mas-ka/ICCC/docs/導通チェッカー_基板製作図.pdf

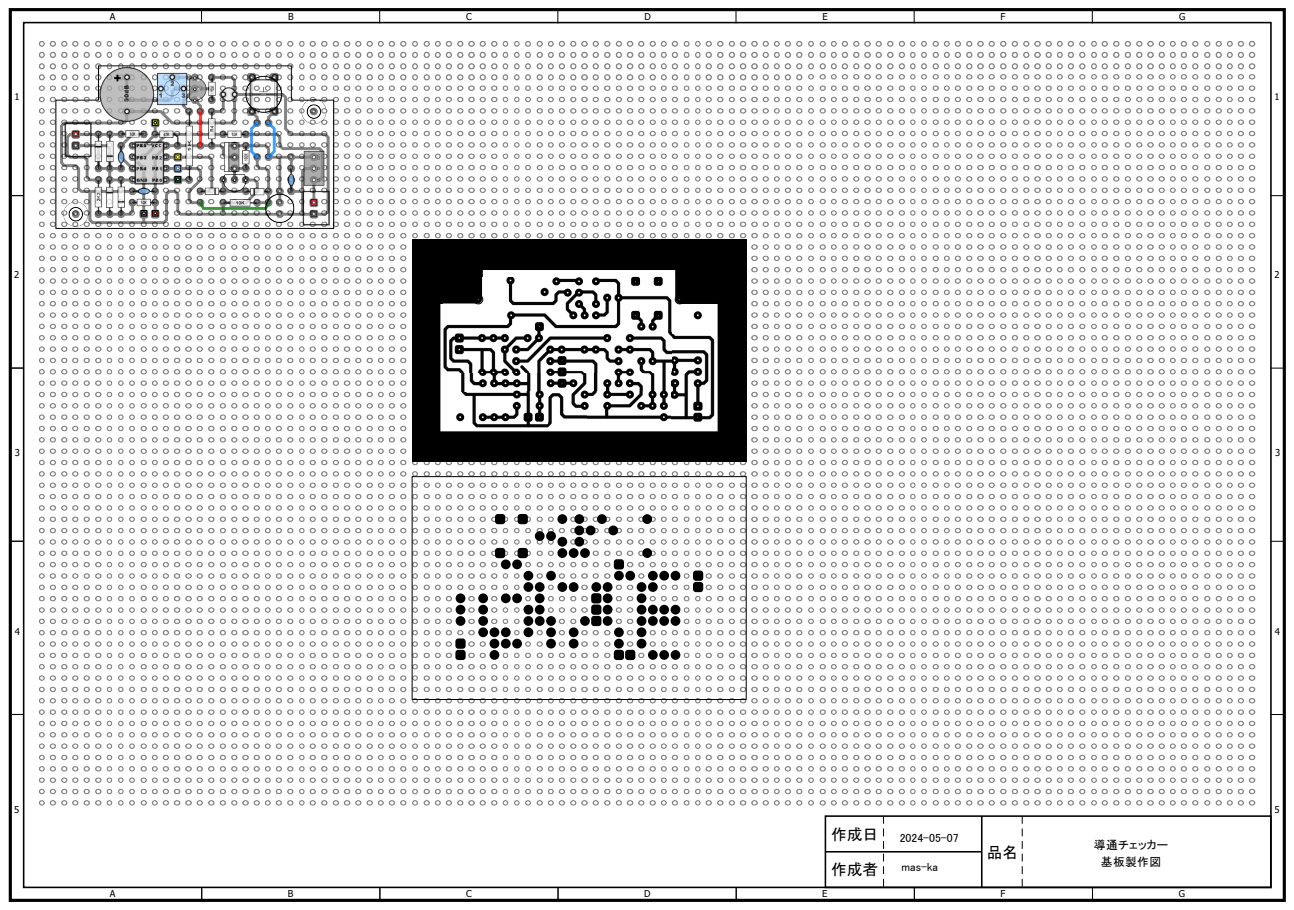
[picture p1: page 1]
作成日; 作成者; mas-ka; 導通チェッカー; 基板製作図
