mas-ka/ICCC/docs/導通チェッカー_転写パターン図.pdf

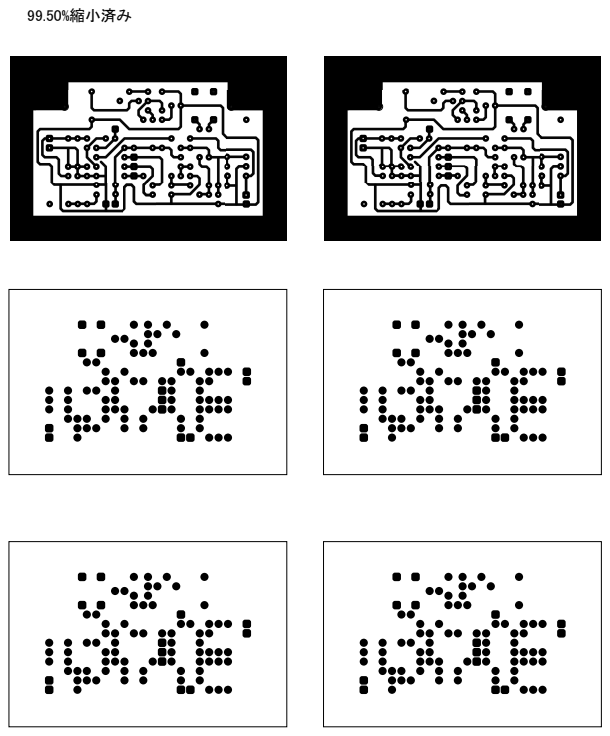
[picture p2: page 1]
99.50%縮小済み
