mas-ka/ICCC/docs/導通チェッカー_電気回路図.pdf

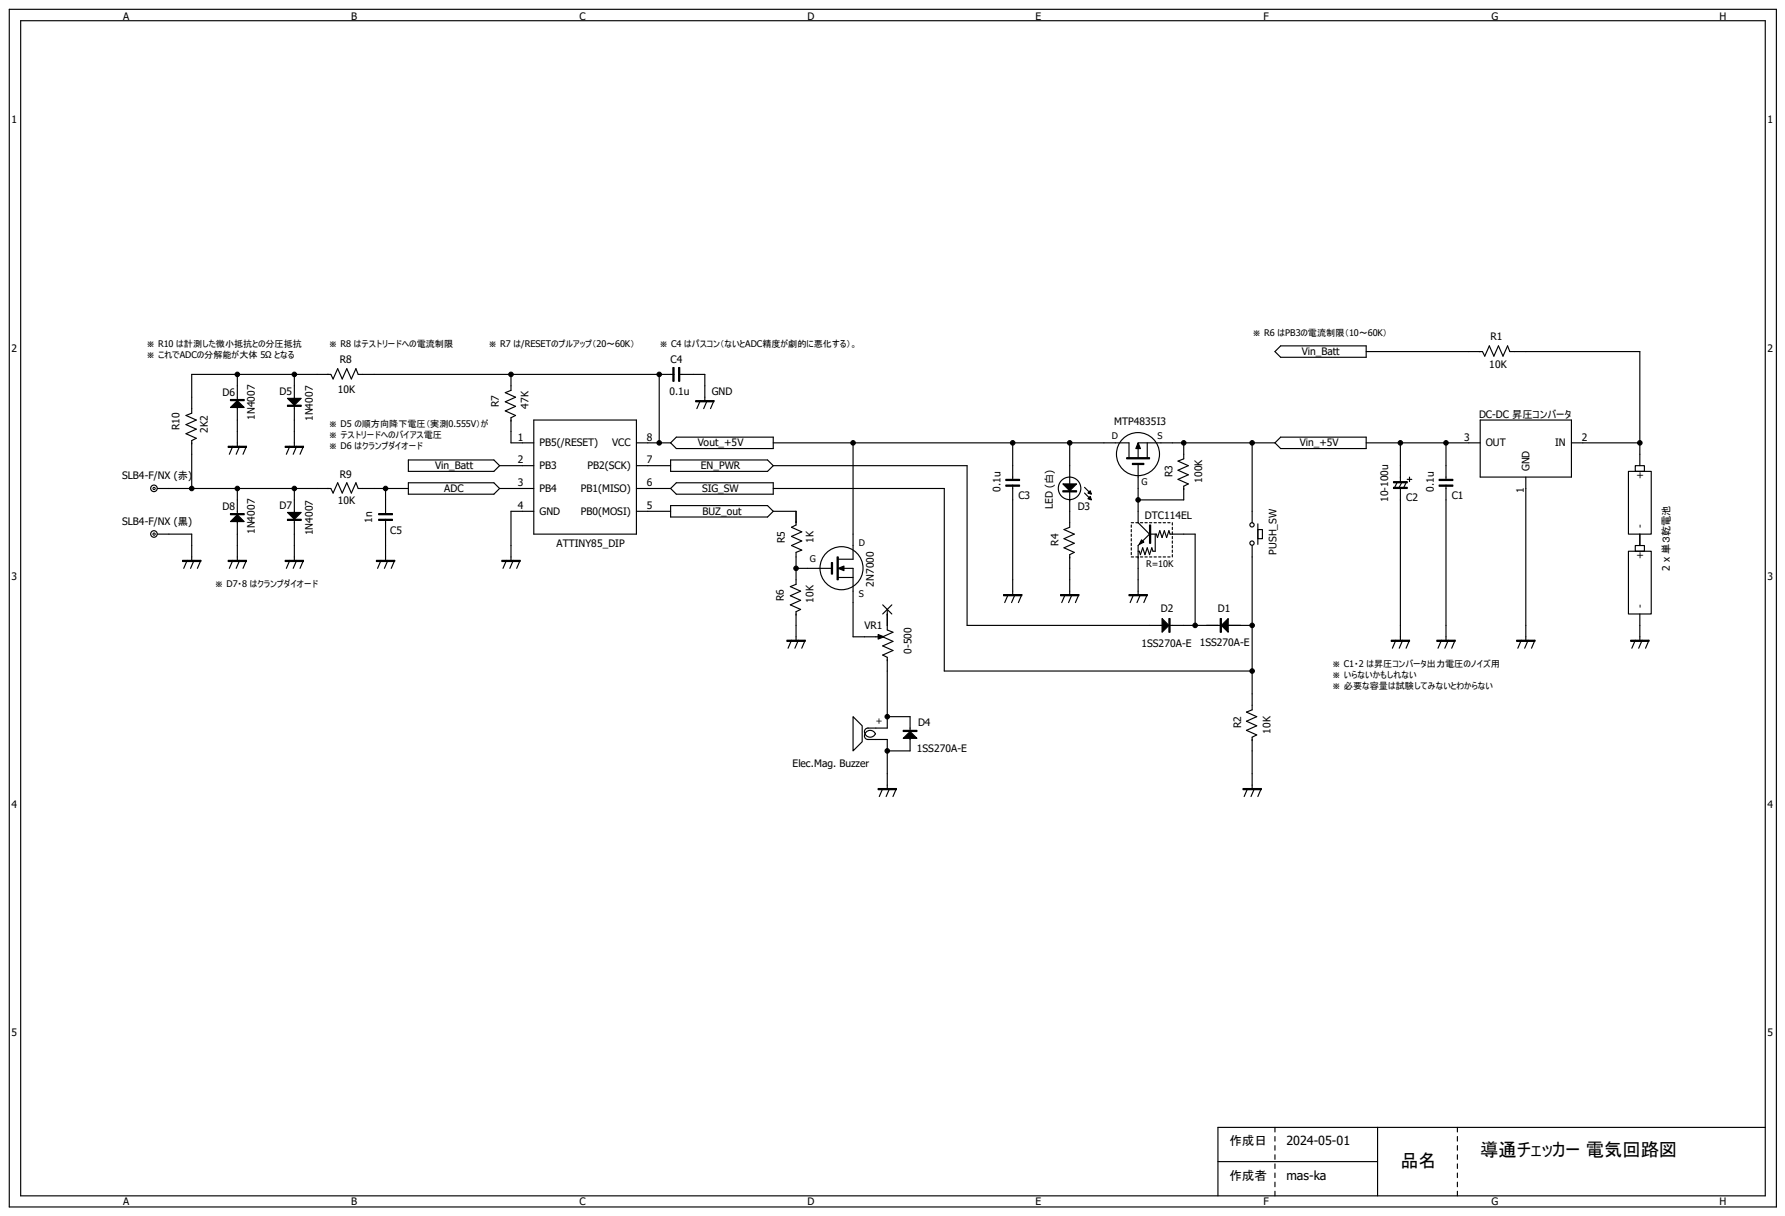
[picture p3: page 1]

作成日 | 2024-05-01 | 導通チェッカー 電気回路図 品名

作成者 | mas-ka
