mas-ka/ICCC/iccc.ino

/*
 * ICCC (In-Circit Conductivity Cheker) for ATTiny85
 * programmed by KAWAMOTO
*/

// ソフトウェアシリアル
//#include <SoftwareSerial.h>
//#define RX_PIN 0   // USB-シリアル変換モジュールのTXへつなぐ
//#define TX_PIN 1   // USB-シリアル変換モジュールのRXへつなぐ
//SoftwareSerial mySerial(RX_PIN, TX_PIN);    // RX,TXの割り当て

// ピンアサイン
#define BZ_PIN    0   // ブザー出力（PB0）
#define SW_PIN    1   // スイッチ入力（PB1）
#define EN_PIN    2   // 電源許可出力（PB2）
#define VBATT_PIN A3  // バッテリー電圧（PB3はA3）
#define TEST_PIN  A2  // テストリード電圧（PB4はA2）

// 変数
#define TONE_HIGH     2776 // 高音の周波数
#define TONE_MIDDLE   920  // 中音の周波数
#define TONE_LOW      552  // 低音の周波数
#define MS_AUTO_POWER_OFF 60000 // 自動電源オフまでのミリ秒
unsigned int count_sw; // スイッチ押下カウンタ
unsigned long ms_last_event; // 最後にテスター検知をした時刻
double adc_test; // テスターのADC値

void setup() {
  // ソフトウェアシリアルの起動
  //mySerial.begin(9600); 
  //mySerial.println("ICCC(ATtiny85) start");
  
  // ピンアサイン
  pinMode(SW_PIN, INPUT);
  pinMode(EN_PIN, OUTPUT);

  // 起動時のバッテリー電圧チェック  
  digitalWrite(EN_PIN, HIGH);   // とりあえず電源許可を出す
  analogReference(DEFAULT);     // ADC基準電圧をVCC+5Vに設定
  delay(100);                   // 100ミリ秒待つ
  if (readVBatt(5.0) < 1.7) {      // バッテリー電圧が1.7V未満だった
    noTone(BZ_PIN); delay(200); // 一旦ブザーを止める
    tone(BZ_PIN, TONE_LOW, 240); delay(250); tone(BZ_PIN, TONE_MIDDLE, 240); delay(250); 
    tone(BZ_PIN, TONE_LOW, 240); delay(250); tone(BZ_PIN, TONE_MIDDLE, 240); delay(250); 
    noTone(BZ_PIN);             // 一旦ブザーを止める
    digitalWrite(EN_PIN, LOW);  // 電源許可を停止
    while(1){;}                 // 停止まで無期限待機
  }
  
  // ADC設定
  analogReference(INTERNAL);  // あらためてADC基準電圧を内部1.1Vに設定

  // 変数のセット
  count_sw = 0;
  ms_last_event = millis();

  // 準備完了のブザー
  noTone(BZ_PIN); delay(50); // 一旦ブザーを止める
  tone(BZ_PIN, TONE_HIGH, 250);
  delay(1000);
}

void loop() {
  // バッテリー残量のチェック
  if (readVBatt(1.1) < 0.9) {// バッテリー残量が0.9V未満となった
    noTone(BZ_PIN); delay(200); // 一旦ブザーを止める
    tone(BZ_PIN, TONE_LOW, 240); delay(250); tone(BZ_PIN, TONE_MIDDLE, 240); delay(250); 
    tone(BZ_PIN, TONE_LOW, 240); delay(250); tone(BZ_PIN, TONE_MIDDLE, 240); delay(250); 
    noTone(BZ_PIN); // 一旦ブザーを止める
    digitalWrite(EN_PIN, LOW); // 電源許可を停止
    while(1){;} // 停止まで無期限待機
  }

  // スイッチのチェック
  if (digitalRead(SW_PIN) == LOW) { // スイッチが押されていない
    count_sw = 0; // スイッチ押下カウントをゼロにリセット
  } else if (count_sw < 5) { // スイッチが押されているがまだ5回に満たない
    count_sw++; // 押下回数をインクリメント
  } else { // 5回以上押し続けられてるので強制電源オフ
    noTone(BZ_PIN); delay(200); // 一旦ブザーを止める
    tone(BZ_PIN, TONE_MIDDLE, 1000); delay(1250); // 高音で1秒発音 
    noTone(BZ_PIN); // 一旦ブザーを止める
    digitalWrite(EN_PIN, LOW); // 電源許可を停止
    while(1){;} // 停止まで無期限待機
  }

  // 自動電源オフのチェック
  if (millis() - ms_last_event > MS_AUTO_POWER_OFF) { // 最後のテスター検知から「自動電源オフ」ミリ秒以上経過した
    noTone(BZ_PIN); delay(200); // 一旦ブザーを止める
    tone(BZ_PIN, TONE_MIDDLE, 1000); delay(1250); // 高音で1秒発音 
    noTone(BZ_PIN); // 一旦ブザーを止める
    digitalWrite(EN_PIN, LOW); // 電源許可を停止
    while(1){;} // 停止まで無期限待機
  }

  // テスター検知のチェック
  adc_test = readADCTest();
  if (adc_test < 2.0) { // ADC値が2（大体10Ω）未満
    tone(BZ_PIN, TONE_HIGH); // 高音連続音
    ms_last_event = millis(); // テスター検知時刻を更新
  } else if (adc_test < 10.0) { // ADC値が2（10Ω）以上 10（50Ω）未満
    noTone(); // ブザーを止める
    tone(BZ_PIN, TONE_MIDDLE, 200); delay(250); // 低音断続音
    ms_last_event = millis(); // テスター検知時刻を更新
  } else { // 絶縁状態
    noTone(); // ブザーを止める
  }

  delay(50);
}

/*
 * バッテリー電圧の取得（内部基準電圧1.1V以上は全て1.1を返す）
*/
double readVBatt(double vref) {
  unsigned long sum = 0L;
  for (int i= 0 ; i < 10 ; i++) sum += analogRead(VBATT_PIN);
  return (vref * sum / 10240);  
}

/*
 * テスターADC値の取得
*/
double readADCTest() {
  unsigned long sum = 0L;
  for (int i= 0 ; i < 10 ; i++) sum += analogRead(TEST_PIN);
  return (sum / 10);  
}
