mas-ka/ICCC/(commit log)

2024-05-01 とりあえずコード書き始めた
2024-05-02 Vbattの電流取得を10回平均を取るようにした……が「is_battery_OK」ではなく、電圧値を返す関数にしたほうが使い勝手がイイか？
2024-05-02 テスター電圧検知を色々と試してる最中
2024-05-03 色々と試験中
2024-05-05 ブザーの音量と周波数を調べるコードを書いた
2024-05-08 実機動作試験のための修正
2024-05-08 本番コードができた。実機での動作確認OK！
2024-05-08 動作周波数を1MHzにし、ブザー音の周波数もちょっとだけ変更した。
2024-05-08 自動電源オフまでの時間を60秒に変更した
2024-05-09 起動時にVRef=VCC+5Vでバッテリー電圧をチェックし1.7V未満なら電源オフにするようにした（loop内はVRef=1.1Vで0.9V未満のまま）。実機動作試験OK。
2024-05-09 電源投入時に「ピッ」と短音を鳴らすようにした。
2024-05-09 ケースの蓋を閉じた状態で最大音量が出る周波数を調べ直した
2026-09-16 docs: 設計資料(docs)の追加、README.mdの作成、不要なdemoの削除
2026-09-16 docs: LICENSE(MIT)の追加およびREADME.mdへの反映
